mawoka-myblock/aquarium-lid-pcb/firmware/src/tasks/http/frontend/README.md

# `create-preact`

<h2 align="center">
  
</h2>

<h3 align="center">Get started using Preact and Vite!</h3>

## Getting Started

-   `pnpm dev` - Starts a dev server at http://localhost:5173/

-   `pnpm build` - Builds for production, emitting to `dist/`

-   `pnpm preview` - Starts a server at http://localhost:4173/ to test production build locally
