mawoka-myblock/aquarium-lid-pcb/aquarium-lid.kicad_pcb

## KiCad design aquarium-lid.kicad_pcb (2025-08-05)

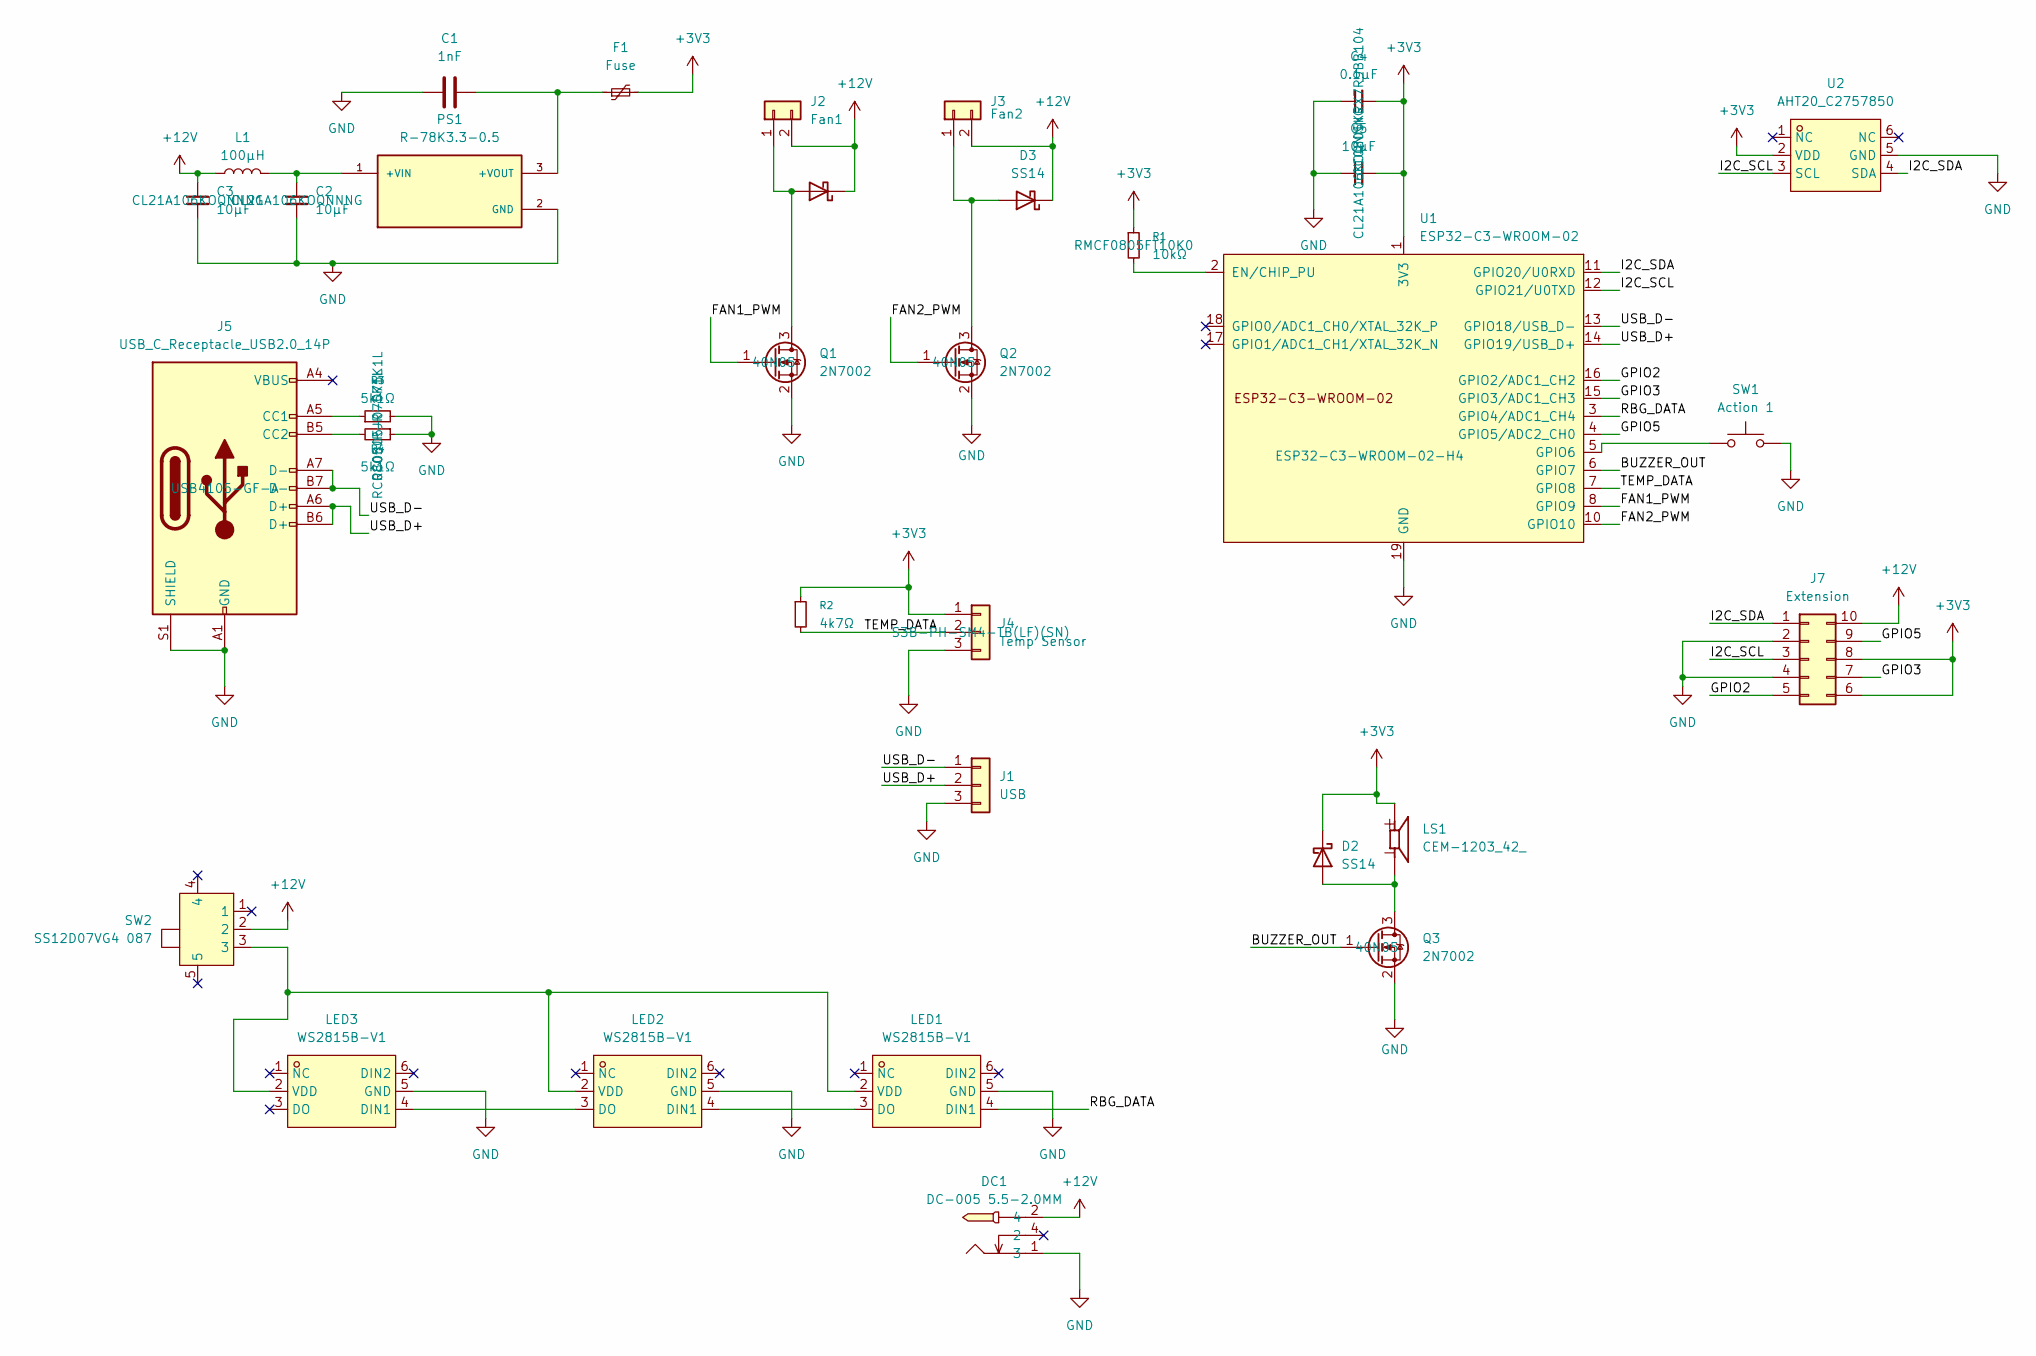
[picture p1: schematic aquarium-lid.kicad_sch]

Parts:
C1: 1nF; C_0805_2012Metric
C2, C3, C5: 10µF; C_0805_2012Metric
C4: 0.1µF; C_0805_2012Metric
D2, D3, D4: SS14; D_SMA
DC1: DC-005 5.5-2.0MM; DC-IN-TH_DC-5520-1; LCSC Part C16214
F1: Fuse; Fuse_1206_3216Metric
J1: USB; PinHeader_1x03_P2.54mm_Vertical
J2: Fan1; JST_XH_S2B-XH-A-1_1x02_P2.50mm_Horizontal
J3: Fan2; JST_XH_S2B-XH-A-1_1x02_P2.50mm_Horizontal
J4: Temp Sensor; JST_PH_S3B-PH-SM4-TB_1x03-1MP_P2.00mm_Horizontal
J5: USB_C_Receptacle_USB2.0_14P; USB_C_Receptacle_GCT_USB4105-xx-A_16P_TopMnt_Horizontal
J7: Extension; PinHeader_2x05_P2.54mm_Vertical
L1: 100µH; IND-SMD_L7.8-W7.0-A
LED1, LED2, LED3: WS2815B-V1; LED-SMD_6P-L5.0-W5.0-P1.60-LS5.4-BR; LCSC Part C5446699
LS1: CEM-1203_42_; CUI_CEM-1203_42_
PS1: R-78K3.3-0.5; CONV_R-78K3.3-0.5; PARTREV 0/2023
Q1, Q2, Q3: 2N7002; SOT-23
R1: 10kΩ; R_0805_2012Metric
R2: 4k7Ω; R_0805_2012Metric
R3, R4: 5k1Ω; R_0805_2012Metric
SW1: Action 1; SW_TS04-66-43-BK-100-SMT
SW2: SS12D07VG4 087; SW-TH_SS12D07VG4; LCSC Part C2939726
U1: ESP32-C3-WROOM-02
U2: AHT20_C2757850; SENSOR-SMD_L3.0-W3.0-P1.00-BR; LCSC Part C2757850

Connections:
+3V3: C4.2, C5.2, D2.1 (K), F1.2, J4.1, J7.6, J7.8, LS1.P, R1.1, R2.1, U1.1 (3V3), U2.2 (VDD)
+12V: C3.1, D3.1 (K), D4.1 (K), DC1.2 (4), J2.2, J3.2, J7.10, L1.1, SW2.2
/BUZZER_OUT: Q3.1 (G), U1.6 (GPIO7)
/FAN1_PWM: Q1.1 (G), U1.8 (GPIO9)
/FAN2_PWM: Q2.1 (G), U1.10 (GPIO10)
/GPIO2: J7.5, U1.16 (GPIO2/ADC1_CH2)
/GPIO3: J7.7, U1.15 (GPIO3/ADC1_CH3)
/GPIO5: J7.9, U1.4 (GPIO5/ADC2_CH0)
/I2C_SCL: J7.3, U1.12 (GPIO21/U0TXD), U2.3 (SCL)
/I2C_SDA: J7.1, U1.11 (GPIO20/U0RXD), U2.4 (SDA)
/RBG_DATA: LED1.4 (DIN1), U1.3 (GPIO4/ADC1_CH4)
/TEMP_DATA: J4.2, R2.2, U1.7 (GPIO8)
/USB_D+: J1.2, J5.A6 (D+), J5.B6 (D+), U1.14 (GPIO19/USB_D+)
/USB_D-: J1.1, J5.A7 (D-), J5.B7 (D-), U1.13 (GPIO18/USB_D-)
GND: C1.1, C2.2, C3.2, C4.1, C5.1, DC1.1 (3), J1.3, J4.3, J5.A1 (GND), J5.A12 (GND), J5.B1 (GND), J5.B12 (GND), J5.S1 (SHIELD), J7.2, J7.4, LED1.5 (GND), LED2.5 (GND), LED3.5 (GND), PS1.2 (GND), Q1.2 (S), Q2.2 (S), Q3.2 (S), R3.2, R4.1, SW1.2, U1.9 (GND), U1.19 (GND), U2.5 (GND)
unnamed: D2.2 (A), LS1.N, Q3.3 (D)
unnamed: D3.2 (A), J3.1, Q2.3 (D)
unnamed: D4.2 (A), J2.1, Q1.3 (D)
unnamed: J5.A5 (CC1), R3.1
unnamed: J5.B5 (CC2), R4.2
unnamed: LED1.3 (DO), LED2.4 (DIN1)
unnamed: LED1.2 (VDD), LED2.2 (VDD), LED3.2 (VDD), SW2.3
unnamed: LED2.3 (DO), LED3.4 (DIN1)
unnamed: C2.1, L1.2, PS1.1 (+VIN)
unnamed: C1.2, F1.1, PS1.3 (+VOUT)
unnamed: R1.2, U1.2 (EN/CHIP_PU)
unnamed: SW1.1, U1.5 (GPIO6)

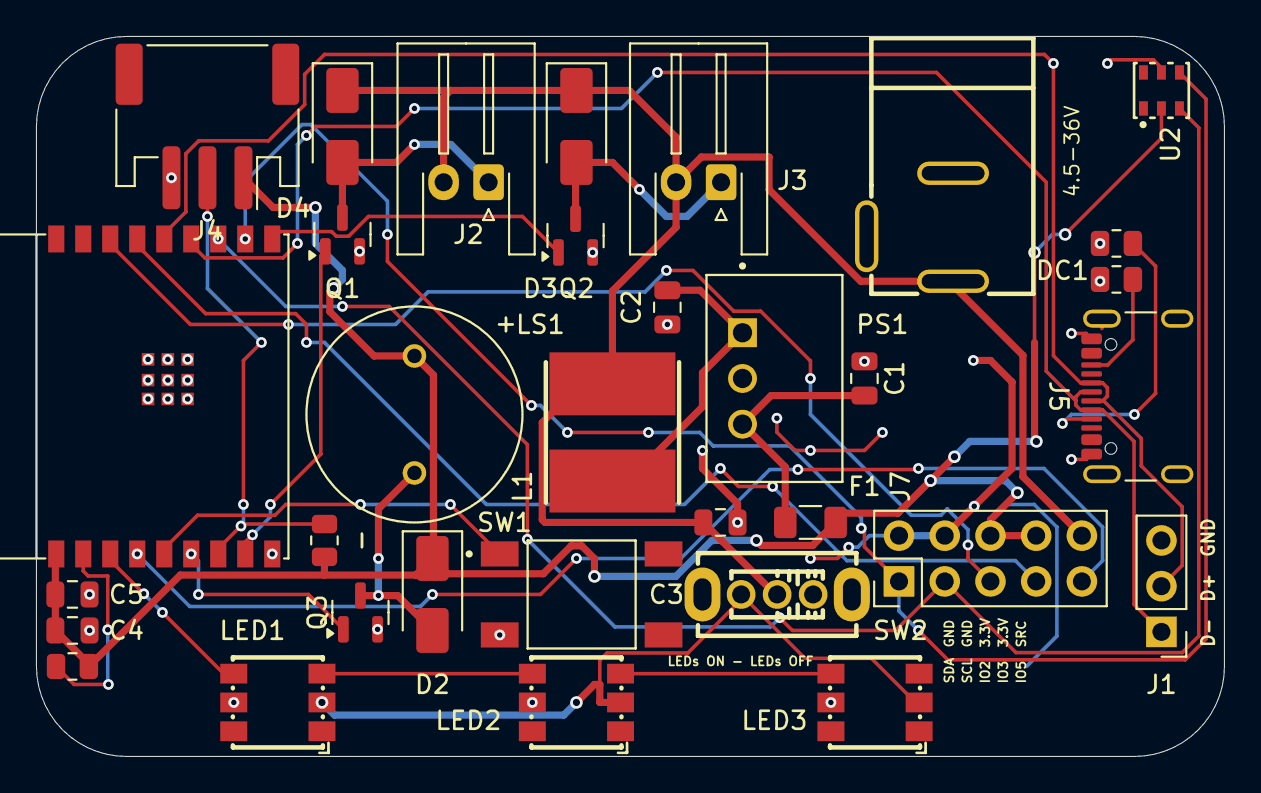
[picture p2: board aquarium-lid.kicad_pcb from above]

Board: 2 copper layers, 66.0 x 40.0 mm, 33 parts (0 on the bottom side), 27 nets.
