mawoka-myblock/aquarium-lid-pcb/firmware/TODO.md

# ToDo for Firmware

## MQTT
- [ ] Better LED config

## Alarm
- [x] Add alarm task
- [ ] Add listener to silence alarm
- [ ] Expose alarm over MQTT

## Nice to have's
- Fan control curve
- Less unwrap's
