mawoka-myblock/aquarium-lid-pcb/(commit log)

2025-06-03 Quick save
    [aquarium-lid-B_Cu.gbr, aquarium-lid-B_Mask.gbr, aquarium-lid-B_Paste.gbr, aquarium-lid-B_Silkscreen.gbr, aquarium-lid-Edge_Cuts.gbr, aquarium-lid-F_Cu.gbr, aquarium-lid-F_Mask.gbr, aquarium-lid-F_Paste.gbr]
2025-06-20 New PCB
    [aquarium-lid-B_Cu.gbr, aquarium-lid-B_Mask.gbr, aquarium-lid-B_Paste.gbr, aquarium-lid-B_Silkscreen.gbr, aquarium-lid-Edge_Cuts.gbr, aquarium-lid-F_Cu.gbr, aquarium-lid-F_Mask.gbr, aquarium-lid-F_Paste.gbr]
2026-05-05 Cleanup and working LEDC
2026-05-10 :bug: Fix workflow (1)
    [aquarium-lid.step, aquariumfancontroller.yaml, slidcontroller.kicad_pcb, slidcontroller.kicad_sch]
2026-05-10 Add button action
    [aquarium-lid.csv]
2026-06-27 Add rounding to Water Temperature in MQTT
2026-07-14 Use proper fan state instead of assumed one
